AlvaroChi/FermentLab/experiments/esp32/fermentation-session-logger/README.md

# Fermentation Session Logger

Firmware ESP32 che avvia e chiude sessioni dall'interfaccia web locale. Ogni
misura viene salvata localmente su LittleFS prima di essere inviata
a InfluxDB 2.x; indisponibilita' temporanee di Wi-Fi, NAS o InfluxDB non causano
la perdita dell'arretrato.

## Stato del progetto

Il profilo Waveshare ESP32-S3-Zero e' una **milestone stabile, funzionante e
verificata su hardware reale**. START, misurazione, persistenza locale, invio
via Wi-Fi a InfluxDB, STOP e riavvio sono stati validati insieme il 9 agosto
2026. La baseline, le prove e i comportamenti da non alterare sono descritti in
[`MILESTONE_STABLE.md`](MILESTONE_STABLE.md).

InfluxDB 2.x puo' essere eseguito su un PC, per esempio tramite Docker, oppure
su un NAS sempre acceso. Il firmware associa il NAS alla rete Wi-Fi di casa e
il PC alle altre reti configurate, mantenendo localmente le misure quando il
server selezionato non e' disponibile. Il PC non deve essere collegato alla
scheda: con InfluxDB sul NAS, l'ESP32 alimentato autonomamente comunica
direttamente via Wi-Fi.

LittleFS ha capacita' limitata: controllare dalla dashboard l'eventuale
arretrato se InfluxDB resta indisponibile a lungo.

## Hardware

| Funzione | ESP32 classico | Waveshare ESP32-S3-Zero |
|---|---:|---:|
| SDA VL53L0X + SHT3x | GPIO21 | GPIO1 |
| SCL VL53L0X + SHT3x | GPIO22 | GPIO2 |
| Dati DS18B20 | GPIO27 | GPIO4 |
| Pull-up DS18B20 | 4,7 kOhm verso 3V3 | 4,7 kOhm verso 3V3 |
| Alimentazione sensori | 3V3 - GND | 3V3 - GND |

Il profilo hardware viene selezionato in compilazione. Sul profilo ESP32
classico GPIO4 resta libero; sul profilo S3-Zero viene usato dal DS18B20.
GPIO0 (BOOT), GPIO19/20 (USB) e GPIO21 (LED RGB) non vengono usati per i
sensori sullo S3-Zero.

Sul LED RGB dello S3-Zero un breve heartbeat azzurro indica il sistema pronto
e inattivo; un lampeggio arancione lento indica una sessione attiva; un
lampeggio rosso rapido segnala un errore; il verde resta acceso durante una
lettura di test una tantum. Sul LED monocromatico del profilo classico restano
distinguibili le stesse cadenze senza la codifica cromatica.

## Wi-Fi e InfluxDB

Creare il file locale escluso da Git:

```powershell
Copy-Item include/secrets.example.h include/secrets.h
```

Compilare quindi `include/secrets.h` con SSID, password, URL del NAS, token,
organization e bucket. La configurazione attesa e':

```cpp
#define INFLUXDB_URL "http://<IP_NAS>:8086"
#define INFLUXDB_ORG "FermentLab"
#define INFLUXDB_BUCKET "fermentlab"
```

Il token non viene stampato nei log. `include/secrets.h` e' ignorato da Git;
nel repository rimane soltanto `include/secrets.example.h` con placeholder.
Sulla rete indicata da `INFLUX_HOME_WIFI_SSID` viene usato il profilo NAS;
sulle altre reti viene usato il profilo PC. Se il profilo selezionato non e'
raggiungibile, le misure restano nella coda persistente senza tentare endpoint
appartenenti a un'altra rete.

## Coda persistente e recupero

- le misure Influx Line Protocol vengono accodate in segmenti append-only in
  `/influx-queue` su LittleFS;
- ogni record viene terminato e sincronizzato prima che possa essere inviato;
- la presenza nel segmento equivale allo stato `not sent`;
- il segmento piu' vecchio viene inviato a `/api/v2/write` e cancellato solo
  dopo una risposta HTTP 2xx;
- timeout e backoff esponenziale evitano retry serrati;
- dopo reboot vengono recuperate tutte le righe complete; un'eventuale coda
  incompleta causata da un'interruzione di alimentazione non viene estesa;
- un retry dopo un reset puo' reinviare un batch gia' accettato: stessi tag e
  timestamp rendono la scrittura idempotente in InfluxDB.

La misura `fermentation_measurement` usa i tag `device_id` e `session_id` e
campi per sequenza, tempo trascorso, temperature, umidita', distanza, altezza e
volume. InfluxDB usa timestamp con precisione in secondi.

## Funzionamento

- connessione Wi-Fi, sincronizzazione NTP e recupero coda avvengono in
  background con una macchina a stati non bloccante;
- **START** dalla dashboard: avvio sessione quando l'orologio e' gia' sincronizzato;
- START non scrive sulla coda LittleFS nel percorso critico; persistenza e
  accodamento iniziano con il normale ciclo di misura;
- lettura immediata, poi secondo l'intervallo scelto nella bozza di sessione;
- **STOP** dalla dashboard: chiusura e rinomina del file nella memoria dell'ESP32;
- dopo la chiusura stampa automaticamente l'intero JSONL nel Serial Monitor;
- fuso `Europe/Rome`, con passaggio automatico CET/CEST;
- ID hardware derivato dall'eFuse MAC dell'ESP32;
- distanza filtrata con mediana di 7 letture e tabella di calibrazione del case
  finale validata tra 10 e 148 mm;
- temperatura e umidita' SHT3x protette da controllo CRC;
- temperatura impasto DS18B20 a 12 bit, acquisita senza attese bloccanti.

Il sensore SHT3x popola la temperatura ambiente; il DS18B20 sul GPIO definito
dal profilo hardware popola la temperatura impasto nel JSONL e in InfluxDB. La
resistenza da 4,7 kOhm deve collegare il filo dati a 3V3. L'altezza impasto usa
il fondo fisico del vaso a 148 mm dal riferimento esterno del case. Il volume
resta assente finche' `CONTAINER_CROSS_SECTION_CM2` non viene configurato.

## Interfaccia web locale

Quando il Wi-Fi e' connesso, l'ESP32 espone una pagina di controllo sulla rete
locale:

```text
http://fermentlab.local
```

Se il telefono o il router non risolvono mDNS, usare l'indirizzo IP mostrato
nel log `web_ready` oppure nella lista client del router, ad esempio
`http://192.168.68.x`.

La pagina offre:

- **Test lettura**: acquisisce un campione DS18B20/SHT3x/VL53L0X e lo mostra nella
  pagina senza salvarlo su LittleFS e senza inviarlo a InfluxDB;
- **START/STOP**: avvia e termina la sessione direttamente dalla dashboard;
- stato sessione, timestamp, IP, segnale Wi-Fi e uptime;
- intervallo previsto, letture effettuate, tempo alla prossima lettura e ultima
  misura;
- numero reale di letture in coda, segmenti e byte della coda InfluxDB
  persistente.

### Impasto, farine e preset

La pagina separata `http://fermentlab.local/config` (raggiungibile anche dal
pulsante **Impasto e farine** nella dashboard) permette di gestire senza editor
JSON:

- il catalogo personale delle farine, con marca, nome, tipo, proteine, W, P/L,
  note e fonte;
- preset riutilizzabili con una o piu' farine, percentuali della miscela,
  idratazione, sale, lievito e autolisi;
- la configurazione del prossimo impasto, anche partendo da un preset;
- esportazione e importazione di un backup JSON completo.

Al primo avvio vengono aggiunte Caputo Pizzeria e Caputo Nuvola con i dati
delle schede ufficiali. Italiamo Nuvola viene aggiunta con marca e nome, ma i
dati tecnici restano volutamente vuoti finche' non vengono copiati
dall'etichetta della confezione. I due preset inclusi sono esempi modificabili,
non ricette universali.

I documenti sono salvati in `/recipe-config` su LittleFS. Ogni modifica usa un
file temporaneo e una copia di recupero; catalogo e preset non vengono riscritti
durante le normali misurazioni. Gli ID e i riferimenti tra farine, preset e
impasto vengono validati prima della sostituzione. Durante una sessione attiva
l'interfaccia e le API rifiutano qualsiasi modifica.

Allo START la prima riga del JSONL include `recipe`: e' una fotografia della
configurazione corrente, comprese le schede delle farine e i grammi calcolati.
Modificare in seguito una farina o un preset non cambia quindi le sessioni gia'
registrate.

La pagina mostra separatamente lo stato di VL53L0X, SHT3x, DS18B20, LittleFS, coda e
NTP. Se un sensore non e' disponibile, START restituisce il motivo preciso e il
firmware tenta automaticamente una nuova inizializzazione ogni 15 secondi,
senza richiedere un riavvio.

L'interfaccia non richiede Internet, ma telefono ed ESP32 devono essere sulla
stessa rete locale. Non e' presente autenticazione: non pubblicare la porta 80
del dispositivo su Internet e usare una rete Wi-Fi considerata affidabile.

## Alimentazione senza PC

L'ESP32 puo' funzionare dalla porta USB con un normale alimentatore da telefono
5 V / 2 A. I 2 A indicano la corrente massima disponibile: la scheda assorbe
solo quella necessaria. Usare un cavo USB affidabile e verificare dalla pagina
che uptime, letture e invii continuino senza riavvii. Il buffer LittleFS
mantiene l'arretrato anche se durante la prova Wi-Fi o NAS non sono disponibili.

## Compilazione e caricamento

Compilare esplicitamente entrambi i profili prima di modifiche condivise:

```powershell
pio run -e esp32dev
pio run -e esp32s3zero
```

Caricamento su ESP32 classico:

```powershell
pio run -e esp32dev --target upload --upload-port COM3
```

Caricamento su Waveshare ESP32-S3-Zero standard da 4 MB:

```powershell
pio run -e esp32s3zero --target upload
```

Lo S3-Zero usa USB nativa: se non entra automaticamente in download, tenere
premuto BOOT (GPIO0), premere e rilasciare RESET, quindi rilasciare BOOT. La
porta seriale puo' cambiare dopo il primo caricamento. Il modello N8R8 richiede
un ambiente dedicato per la diversa dimensione della flash.

## Serial Monitor

Il normale Serial Monitor di PlatformIO mostra le misure durante la sessione.
Alla chiusura della sessione stampa `file_saved`, seguito dal contenuto completo del
file tra `file_dump_start` e `file_dump_end`.

## Acquisizione opzionale sul PC

Dal terminale integrato aperto nella cartella di questo progetto:

```powershell
python ..\..\..\tools\fermentation_capture.py --port COM3
```

Non aprire contemporaneamente il Serial Monitor di PlatformIO: COM3 puo'
essere usata da un solo programma. I file completi vengono salvati in
`records/fermentations` con formato:

```text
AAAAMMGG_HHMMSS_HHMMSS_ESP32-ID.jsonl
```
