AlvaroChi/FermentLab/experiments/esp32/vl53l0x-characterization/data/esempio_sintetico.csv

distanza_reale_mm | n_totali | n_valide | n_non_valide | media_mm | mediana_mm | std_mm | min_mm | p05_mm | p25_mm | p75_mm | p95_mm | max_mm | errore_media_mm | errore_mediana_mm
20.000 | 200 | 190 | 10 | 22.100 | 22.000 | 1.300 | 18.000 | 20.000 | 21.000 | 23.000 | 24.000 | 26.000 | 2.100 | 2.000
20.000 | 200 | 193 | 7 | 21.900 | 22.000 | 1.200 | 18.000 | 20.000 | 21.000 | 23.000 | 24.000 | 25.000 | 1.900 | 2.000
20.000 | 200 | 188 | 12 | 22.300 | 22.000 | 1.400 | 18.000 | 20.000 | 21.000 | 23.000 | 25.000 | 27.000 | 2.300 | 2.000
30.000 | 200 | 199 | 1 | 31.900 | 32.000 | 0.900 | 29.000 | 30.000 | 31.000 | 32.000 | 33.000 | 34.000 | 1.900 | 2.000
30.000 | 200 | 200 | 0 | 32.100 | 32.000 | 0.800 | 30.000 | 31.000 | 32.000 | 33.000 | 33.000 | 34.000 | 2.100 | 2.000
30.000 | 200 | 200 | 0 | 32.000 | 32.000 | 0.850 | 29.000 | 31.000 | 31.000 | 33.000 | 33.000 | 34.000 | 2.000 | 2.000
40.000 | 200 | 200 | 0 | 42.200 | 42.000 | 0.700 | 40.000 | 41.000 | 42.000 | 43.000 | 43.000 | 44.000 | 2.200 | 2.000
40.000 | 200 | 200 | 0 | 42.000 | 42.000 | 0.750 | 40.000 | 41.000 | 41.000 | 43.000 | 43.000 | 44.000 | 2.000 | 2.000
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
