AlvaroChi/FermentLab/hardware/kicad/fermentlab/fermentlab.kicad_sch

## KiCad design hardware/kicad/fermentlab/fermentlab.kicad_sch (2026-09-12)

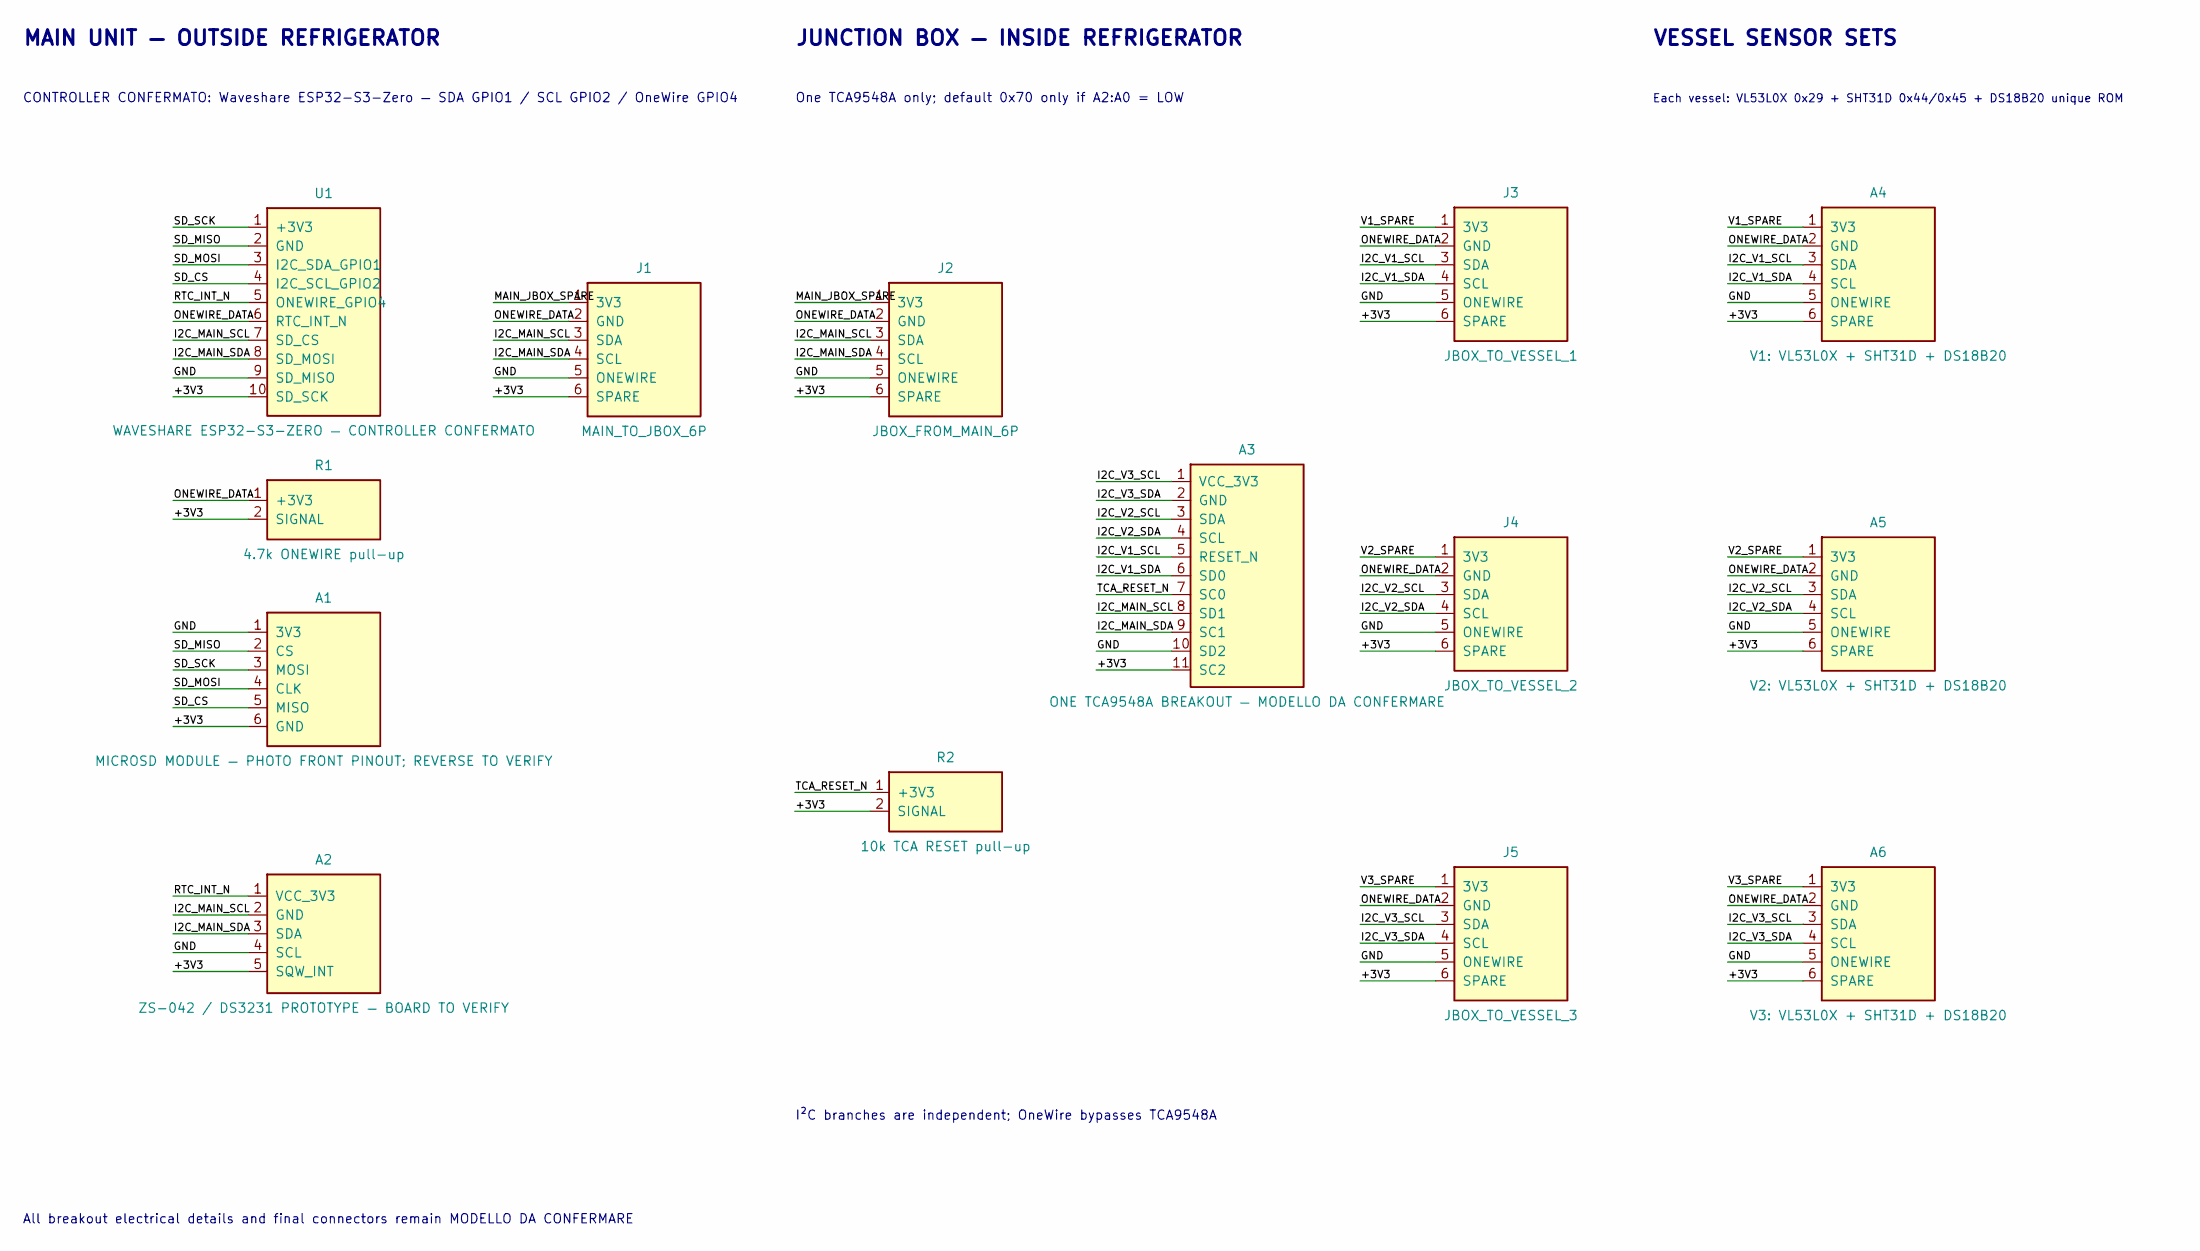
[picture p1: schematic fermentlab.kicad_sch]

Parts:
A1: MICROSD MODULE — PHOTO FRONT PINOUT; REVERSE TO V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
A2: ZS-042 / DS3231 PROTOTYPE — BOARD TO VERIFY
A3: ONE TCA9548A BREAKOUT — MODELLO DA CONFERMARE
A4: V1: VL53L0X + SHT31D + DS18B20
A5: V2: VL53L0X + SHT31D + DS18B20
A6: V3: VL53L0X + SHT31D + DS18B20
J1: MAIN_TO_JBOX_6P
J2: JBOX_FROM_MAIN_6P
J3: JBOX_TO_VESSEL_1
J4: JBOX_TO_VESSEL_2
J5: JBOX_TO_VESSEL_3
R1: 4.7k ONEWIRE pull-up
R2: 10k TCA RESET pull-up
U1: WAVESHARE ESP32-S3-ZERO — CONTROLLER CONFERMATO

Connections:
+3V3: A1.6 (GND), A2.5 (SQW_INT), A3.11 (SC2), A4.6 (SPARE), A5.6 (SPARE), A6.6 (SPARE), J1.6 (SPARE), J2.6 (SPARE), J3.6 (SPARE), J4.6 (SPARE), J5.6 (SPARE), R1.2 (SIGNAL), R2.2 (SIGNAL), U1.10 (SD_SCK)
GND: A1.1 (3V3), A2.4 (SCL), A3.10 (SD2), A4.5 (ONEWIRE), A5.5 (ONEWIRE), A6.5 (ONEWIRE), J1.5 (ONEWIRE), J2.5 (ONEWIRE), J3.5 (ONEWIRE), J4.5 (ONEWIRE), J5.5 (ONEWIRE), U1.9 (SD_MISO)
I2C_MAIN_SCL: A2.2 (GND), A3.8 (SD1), J1.3 (SDA), J2.3 (SDA), U1.7 (SD_CS)
I2C_MAIN_SDA: A2.3 (SDA), A3.9 (SC1), J1.4 (SCL), J2.4 (SCL), U1.8 (SD_MOSI)
I2C_V1_SCL: A3.5 (RESET_N), A4.3 (SDA), J3.3 (SDA)
I2C_V1_SDA: A3.6 (SD0), A4.4 (SCL), J3.4 (SCL)
I2C_V2_SCL: A3.3 (SDA), A5.3 (SDA), J4.3 (SDA)
I2C_V2_SDA: A3.4 (SCL), A5.4 (SCL), J4.4 (SCL)
I2C_V3_SCL: A3.1 (VCC_3V3), A6.3 (SDA), J5.3 (SDA)
I2C_V3_SDA: A3.2 (GND), A6.4 (SCL), J5.4 (SCL)
MAIN_JBOX_SPARE: J1.1 (3V3), J2.1 (3V3)
ONEWIRE_DATA: A4.2 (GND), A5.2 (GND), A6.2 (GND), J1.2 (GND), J2.2 (GND), J3.2 (GND), J4.2 (GND), J5.2 (GND), R1.1 (+3V3), U1.6 (RTC_INT_N)
RTC_INT_N: A2.1 (VCC_3V3), U1.5 (ONEWIRE_GPIO4)
SD_CS: A1.5 (MISO), U1.4 (I2C_SCL_GPIO2)
SD_MISO: A1.2 (CS), U1.2 (GND)
SD_MOSI: A1.4 (CLK), U1.3 (I2C_SDA_GPIO1)
SD_SCK: A1.3 (MOSI), U1.1 (+3V3)
TCA_RESET_N: A3.7 (SC0), R2.1 (+3V3)
V1_SPARE: A4.1 (3V3), J3.1 (3V3)
V2_SPARE: A5.1 (3V3), J4.1 (3V3)
V3_SPARE: A6.1 (3V3), J5.1 (3V3)

Notes on the sheet:
MAIN UNIT — OUTSIDE REFRIGERATOR
JUNCTION BOX — INSIDE REFRIGERATOR
VESSEL SENSOR SETS
CONTROLLER CONFERMATO: Waveshare ESP32-S3-Zero — SDA GPIO1 / SCL GPIO2 / OneWire GPIO4
One TCA9548A only; default 0x70 only if A2:A0 = LOW
Each vessel: VL53L0X 0x29 + SHT31D 0x44/0x45 + DS18B20 unique ROM
I²C branches are independent; OneWire bypasses TCA9548A
All breakout electrical details and final connectors remain MODELLO DA CONFERMARE
