AlvaroChi/FermentLab/(commit log)

2026-07-31 Add initial FermentLab structure
    [esempio_sintetico.csv, misure_template.csv]
2026-07-31 Add VL53L0X calibration workflow
2026-07-31 Add VL53L0X calibration comparison plots
2026-07-31 Add button-controlled fermentation height monitor
2026-07-31 Make serial logger prompt sensor-neutral
2026-07-31 Use GPIO4 for session button
2026-08-01 Add ESP32 web control interface
2026-08-01 Add automatic sensor recovery
2026-08-01 Add I2C bus diagnostics
2026-08-01 Harden first boot and I2C recovery
2026-08-01 Remove hardware session button
2026-08-01 Add DS18B20 dough temperature
2026-08-01 Add ESP32-S3-Zero build profile
2026-08-04 Add configurable sessions and WiFi failover
    [Config.h, SessionConfigStore.cpp, SessionConfigStore.h, main.cpp, secrets.example.h]
2026-08-04 Calibrate final enclosure distance measurements
2026-08-05 Support onboard WS2812 status LED on ESP32-S3 Zero
2026-08-05 Harden PC/NAS prototype operation
2026-08-06 revert: rollback dashboard draft expansion regression
    [main.cpp]
2026-08-06 Mitigate START reset by skipping session_start file write
    [main.cpp]
2026-08-07 prioritize web toggle over influx and cut influx timeout
2026-08-07 firmware: avoid session_start queue write during start
    [main.cpp]
2026-08-07 diag: expose reset reason in status endpoint
    [main.cpp]
2026-08-07 start: defer first measurement to avoid immediate panic path
    [main.cpp]
2026-08-07 debug: add panic safe mode and crash breadcrumb diagnostics
    [main.cpp]
2026-08-07 fix: correct status json after diagnostics fields
    [main.cpp]
2026-08-07 debug: preserve boot panic breadcrumb across reset
    [main.cpp]
2026-08-07 fix: disable session file writes in panic safe mode
    [main.cpp]
2026-08-07 fix: disable measurements in panic safe mode
    [main.cpp]
2026-08-07 fix: minimal start path in panic safe mode
    [main.cpp]
2026-08-07 fix: handle toggle immediately and reduce status poll burst
    [main.cpp]
2026-08-07 experiment: silence panic-safe start path
    Future me: this removes the last panic-safe START side effects (warning emitEvent calls) while keeping real timestamp/sessionId creation. If PANIC still happens here, the issue is not the extra logging/events; inspect the serial panic trace and the HTTP request context next.
    [main.cpp]
2026-08-07 fix: queue start handling to avoid http timeout
    Future me: START is back to deferred execution so the POST handler returns immediately. Keep the lightweight status payload and relative-time measurements; if timeouts come back, inspect the web request path before touching sensor or queue code.
    [main.cpp]
2026-08-07 fix: relax post-start polling and keep toggle deferred
    Future me: POST /api/session/toggle is queued again and the UI waits longer before declaring the device unreachable. This is the right baseline when START is the active path and status responses can lag briefly.
2026-08-07 fix: avoid LittleFS open during session start
    Future me: the START PANIC was reproducible when the session path opened the local LittleFS file. This baseline keeps the session active without the file write path, which is the stable behavior for now.
    [main.cpp]
2026-08-07 ui: move next dough summary near start
    Future me: keep the next-dough preview in the START area instead of mixing it with the sensor/IP details. The dashboard is cleaner, and the bottom metrics now stay technical.
2026-08-08 fix: keep LittleFS writes out of session start
    [main.cpp]
2026-08-09 fix: recover safely from interrupted queue writes
    [PersistentQueue.cpp, main.cpp]
2026-08-09 docs: mark ESP32-S3 logger stable milestone
2026-08-10 Add text-first fermentation fingerprint analysis
    Introduce a quantitative fingerprint engine for growth thresholds, timing, dynamics, phases, collapse detection, and thermal metrics, with CSV and JSON exports.
    Make parameter tables the default for single-session and multi-session analysis while keeping individual and comparison charts available as explicit drill-down views. Add temperature curves, dark-theme readability improvements, documentation, and synthetic regression tests.
2026-08-10 Improve analyzer result navigation and session management
    Add an explicit TESTO/GRAFICI switch to single-session and multi-session analysis, and replace the styled comparison output with a reliable text-first table that labels missing values and extrema.
    Simplify administrative deletion with per-session checkboxes, aggregate duration and record counts, and one final confirmation dialog. Separate information and merge selectors and update the documentation.
2026-09-12 chore(hardware): preserve current KiCad project
    [fermentlab.kicad_sch, fermentlab.sch, logical-netlist.csv, standard-symbol-test.sch]
